nmroboticsuser-prog/Coglet/3D Printing Files/CogletC0_6.3mf

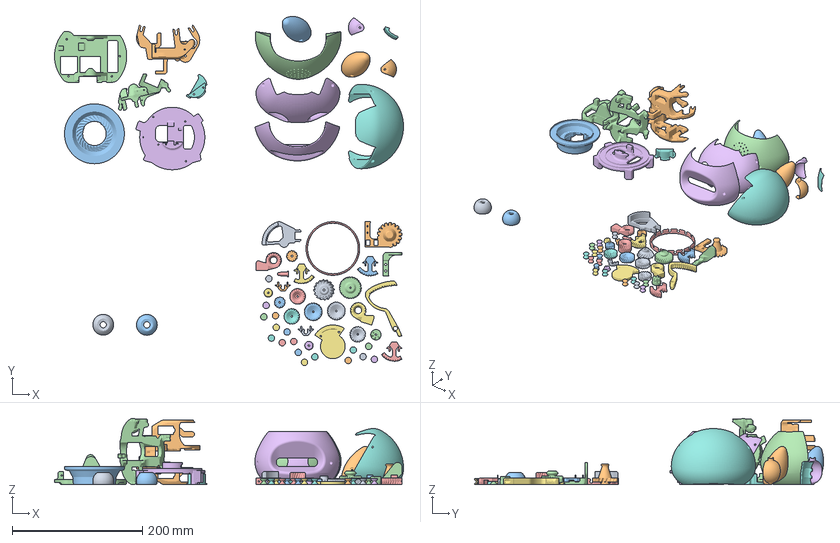
[picture p1: CAD file, 2026-10-05]
3D Printing Files/CogletC0_6.3mf
536.0 x 536.2 x 101.7 mm
Full.stl_32 x 2
Full (5).stl_1
Full (5).stl_2
Full.stl_35
Full.stl_48
Full.stl_58
Full.stl_20
Full.stl_8
Full.stl_19
Full.stl_31
Exterior - Eyelid.stl
Full.stl_26 x 2
Full.stl_30
Full.stl_38
Full.stl_16
Full.stl_65
Full.stl_64
Full.stl_52
Full.stl_29
Full.stl_45
Full.stl_25
Full - BottomPlug.stl
Full.stl_18
Full.stl_7
Full.stl_22
Full - Part 24.stl
Full.stl_9
Full - BodyMiddlePlatform.stl
Full (4).stl_1
Full.stl_53
Full.stl_57
Full (3).stl_2
Full (3).stl_1
Full.stl_2
Full.stl_24
HeadMech - EarLock.stl x 2
Full.stl_10 x 17
Full - EyeAdaptorR.stl x 2
Full - Foot (1).stl
Full - BodyTopPlatform (3).stl
