nmroboticsuser-prog/Coglet/(commit log)

2026-09-28 Add default servo wiring section to datasheet
2026-09-28 sleep torque
2026-10-02 Mechanical improvements
    Updated base to fit skins better, and eyeclips to hold camera better
    [CogletC0_5.3mf]
2026-10-05 Fixed fatal error with foot component missing gear teeth, and adjusted top base platform to have better screw access
    [CogletC0_5.3mf, CogletC0_6.3mf]
